Eli-S-Bridge/ETAG_V10/README.md

# ETAG_V10
ETAG arduino code and assembly files for the ETAG RFID reader version 10.
