Eli-S-Bridge/ETAG_V10/ETAG_v10.1_BOM.xls

 |  | ETAG_V10.1 BOM
Quantity | Designator | Description | Value | Footprint | Manufacturer | Part Number | Vendor | price each | purchase volume | notes
1 | Y4 | Crystal oscillator | 32.768Khz | SMD 3.2 mm x 1.5 mm | ABRACON | ABS07-32.768KHZ-T | Vericle | 0.286 | 213 | special price
1 | BAT | Battery cell clip for CR1620 | 16mm | 16MM_Coin_Cell | Keystone electronics | SMTM1632 (https://www.mouser.com/ProductDetail/Renata/SMTM1632?qs=aopNjFtpd%2FvxeJ7rSsRdhg%3D%3D) | Mouser | 0.257 | 100
1 | L1 | Power inductor | 2.2uH | SMT_4X4MM | Bourns | SRN4018TA-2R2M
1 | CREF | Tantalum Capacitor | 4.7uF | SMT 1206 | AVX | TAJA475M016RNJ
1 | F1 | Resettable Fuse PPTC | 6V/0.5A | SMT 1206 | Littlefuse | 1206L050/15YR | Mouser | 0.29 | 100
1 | FLASH | 4-Mbit SPI flash memory | AT45DB041BWIDE | SOIC-8 | Adesto Technologies | AT45DB321E-SHF-B | mouser | 2.63 | 100 | special price (tube) | WinSource | 0.91 | 160 | special price (tube)
1 | D1 | high-speed Switching Diodes | CD1206-S01575 | SMT 1206 | Bourns | CD1206-S01575
1 | Q1 | Power transistor | FDN360P | SSOT-3 | Vishay | SI2323DDS-T1-GE3
1 | VREG | 3.3V voltage regulator | LM3671 | SOT23-5 | ON Semiconductor | LM3671MFX-3.3/NOPB | Winsource | 0.65 | 155
1 | RTC | Real time clock | RV-3029-C3-I2C | SMT 3.7 mm x 2.5 mm | Microcrystal | RV-3129-C3 32.768kHz OPTION B TB QA | Mouser | 2.81 | 100
1 | AT_SAM | Atmel SAML21J Microcontroller | SAMD21J18A | TQFP64_10MM_0.5PITCH | Microchip/Atmel | ATSAMD21J18A-AU | Microchip | 3.5 | 160 tray
1 | SD | SD MMC Card holder | SDMMC06132 | SMT | TE Connectivity | 2041021-4 |  | 1
1 | RESET | Pushbutton 6x6 Smd | TS42031-160R-TR-7260 | SMT-TS42 | TE Connectivity | FSM1LPATR | AliExpress | 0.1 | 200
1 | USB | SMD Mini USB socket | USB-MINIB-5PIN | USB-MINIB | CUI inc | UJ2-MBH-1-SMT-TR | AliExpress | 0.13 | 100
1 | LED1 | SMD Chip LED | Yellow (various) | CHIPLED_0805 | Kingbright (various) | APT2012YC (various) | AliExpress
2 | RAA, RAB | Resistor Chip SMD | 22R | SMT 0805 | various | various
2 | CR1A, CR1B | SMD capacitor | 1.2nF, 250V | SMT 0603 | various | various
2 | CV2A, CV2B | SMD capacitor | 1.5nF, 250V | SMT 0603 | various | various
2 | C9, C10 | SMD capacitor | 22pF | SMT 0603 | various | various
2 | CV1A, CV1B | SMD capacitor | 22pF, 250V | SMT 0603 | various | various
2 | RFA, RFB | RFID front end IC | EM4095 | SO16 | EM Microelectronic | EM4095
2 | L6, L7 | Ferrite Bead for GHz Noise | 30 Ohms | SMT 0805 | Bournes | MH2029-300Y | mouser | 0.027 | 1000
3 | R1,R2,R3 | Resistor Chip SMD | 330R | SMT 0603 | various | various
3 | C55, CGA, CGB | SMD capacitor | 1uF | SMT 0603 | various | various
5 | C3.3V, C4, C5V, C12, C13 | SMD capacitor | 10uF | SMT 0805 | various | various
4 | R4, RC, RD, RINT | Resistor Chip SMD | 10k | SMT 0603 | various | various
6 | C7, CD1A, CD1B, CFA, CFB, CRST | SMD capacitor | 10nF | SMT 0603 | various | various
10 | C3, C08, C21, C56, CBLKA, CBLKB, CD2A, CD2B, CR2A, CR2B | SMD capacitor | 100nF | SMT 0603 | various | various
1 | Switch |  |  |  |  | GF-126-0331 | digiKey/mouser | 0.9
3 | CE1, CE2, CE3 | Electolytic capacitor | 150uF | SMT |  |  | AliExpress
1 | Antenna Header |  |  |  |  |  | AliExpress | 0.5
 |  |  |  |  |  |  |  | 13.08
not assembled: SDPU, SDPD, CE1, CE2, CE3, C53, all pin headers, SWITCH
