Eli-S-Bridge/ETAG_V10/(threads)

Thread 1 (2021-05-07):

How to program for arduino ide

jhindes521, 2021-05-07:
Hi Elis

trying to follow your build but haven’t got the foggiest at how to program it from the arduino ide any guidance would be hugely appreciated.
When choosing the rfid etag board I can never find it on the com port or with an uni flashed as an isp.
Think I’ve made an older version of your board
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
