Eli-S-Bridge/ETAG_V10/ETAG_v10.3_NOSDTRANS.brd

## EAGLE design ETAG_v10.3_NOSDTRANS.brd (2024-06-11)

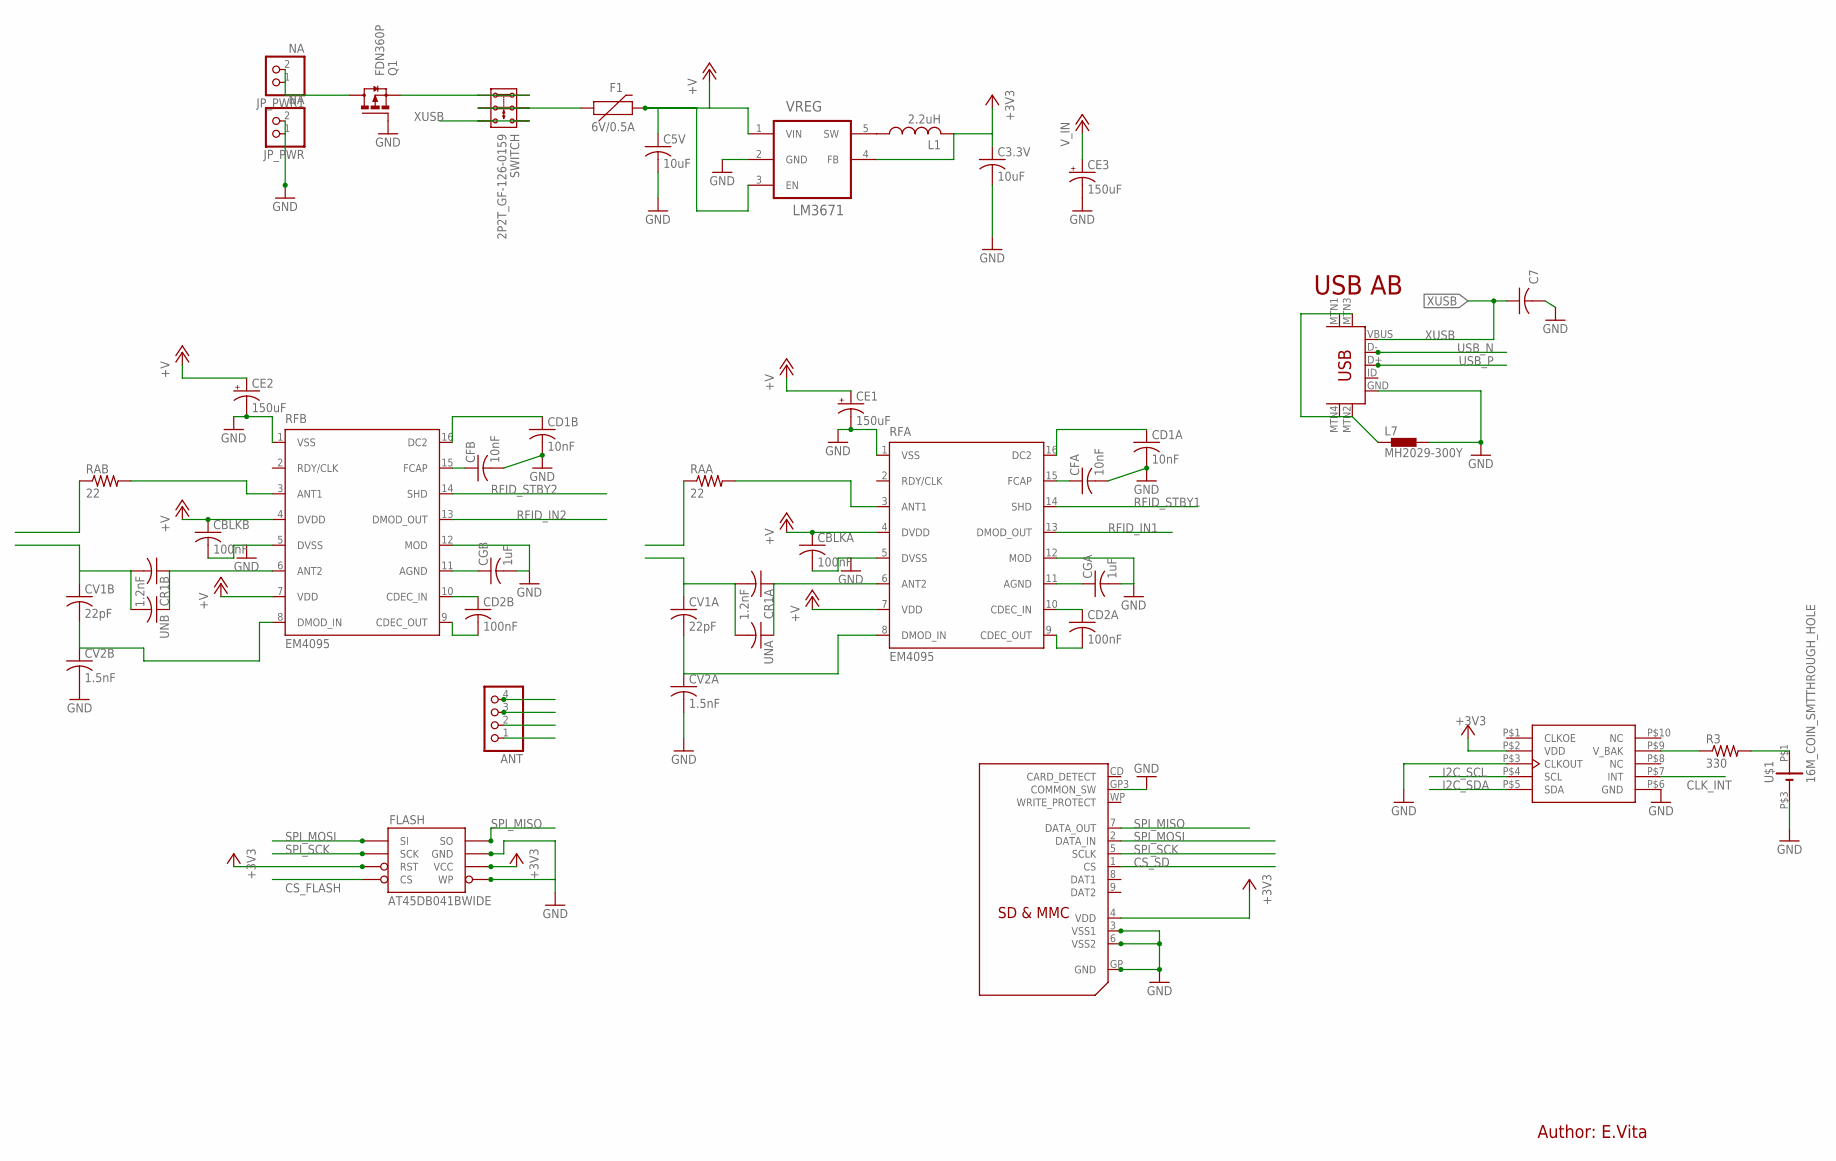
[picture p7: schematic ETAG_v10.3_NOSDTRANS.sch, sheet 1]

Parts:
ANT: PINHD-1X4; 1X04
C3.3V, C5V: 10uF; C0805
C7: 10nF; C0603-ROUND
CBLKA: 100nF; C0603-ROUND
CBLKB: 100nF; C0603-ROUND
CD1A, CD1B: 10nF; C0603-ROUND
CD2A, CD2B: 100nF; C0603-ROUND
CE1, CE2, CE3: 150uF; PANASONIC_C
CFA: 10nF; C0603-ROUND
CFB: 10nF; C0603-ROUND
CGA: 1uF; C0603-ROUND
CGB: 1uF; C0603-ROUND
CR1A, CR1B: 1.2nF; C0603-ROUND
CV1A, CV1B: 22pF; C0603-ROUND
CV2A, CV2B: 1.5nF; C0603-ROUND
F1: 6V/0.5A; 1206
FLASH: AT45DB041BWIDE; SO08WIDE
JP_PWR, JP_PWR1: NA; 1X02
L1: 2.2uH; SMT_COIL_INDUCTOR_4X4MM
L7: MH2029-300Y; C0805K
Q1: FDN360P; SUPER-SOT3
R3: 330; C0603-ROUND
RAA: 22; R0805
RAB: 22; R0805
RFA: EM4095; SO16
RFB: EM4095; SO16
RTC: MC-RTC-RV-3029-C3-I2C; MC-RTC-C3_SPECIAL
SD: SDMMC06132; 06132
SWITCH: 2P2T_GF-126-0159
U$1: 16M_COIN_SMTTHROUGH_HOLE; 16_MM_THROUGH_HOLE
UNA: C-US; C0603-ROUND
UNB: C-US; C0603-ROUND
USB: USB-MINIB-5PIN; USB-MINIB
VREG: LM3671; SOT23-5L

Connections:
2GND: L7.1, USB.MTN1 (MTN2), USB.MTN2 (MTN3), USB.MTN3 (MTN1), USB.MTN4
12_IN: JP_PWR1.1, JP_PWR1.2, Q1.3 (D)
+3V3: C3.3V.1, FLASH.3 (RST), FLASH.6 (VCC), L1.P$2 (2), RTC.P$2 (VDD), SD.4 (VDD), VREG.4 (FB); also elsewhere on the board
AANT: ANT.4, RAA.1
BANT: ANT.2, RAB.1
CLK_INT: RTC.P$7 (INT); also elsewhere on the board
CS_FLASH: FLASH.4 (CS); also elsewhere on the board
CS_SD: SD.1 (CS); also elsewhere on the board
CVA: ANT.3, CR1A.2, CV1A.1, UNA.2
CVB: ANT.1, CR1B.2, CV1B.1, UNB.2
GND: C3.3V.2, C5V.2, C7.2, CBLKA.2, CBLKB.2, CD1A.2, CD1B.2, CE1.-, CE2.-, CE3.-, CFA.2, CFB.2, CGA.2, CGB.2, CV2A.2, CV2B.2, FLASH.5 (WP), FLASH.7 (GND), JP_PWR.1, JP_PWR.2, L7.2, Q1.1 (G), RFA.1 (VSS), RFA.5 (DVSS), RFA.12 (MOD), RFB.1 (VSS), RFB.5 (DVSS), RFB.12 (MOD), RTC.P$3 (CLKOUT), RTC.P$6 (GND), SD.3 (VSS1), SD.6 (VSS2), SD.GP (GND), SD.GP3 (COMMON_SW), U$1.P$3 (-), USB.GND, VREG.2 (GND); also elsewhere on the board
I2C_SCL: RTC.P$4 (SCL); also elsewhere on the board
I2C_SDA: RTC.P$5 (SDA); also elsewhere on the board
unnamed: CFB.1, RFB.15 (FCAP)
unnamed: CGB.1, RFB.11 (AGND)
unnamed: CFA.1, RFA.15 (FCAP)
unnamed: CGA.1, RFA.11 (AGND)
unnamed: CD1A.1, RFA.16 (DC2)
unnamed: CR1B.1, RFB.6 (ANT2), UNB.1
unnamed: CV1B.2, CV2B.1, RFB.8 (DMOD_IN)
unnamed: CD1B.1, RFB.16 (DC2)
unnamed: F1.1, SWITCH.P2A (2.1), SWITCH.P2B (2.2)
unnamed: CD2B.2, RFB.9 (CDEC_OUT)
unnamed: CR1A.1, RFA.6 (ANT2), UNA.1
unnamed: CV1A.2, CV2A.1, RFA.8 (DMOD_IN)
unnamed: CD2B.1, RFB.10 (CDEC_IN)
unnamed: RAB.2, RFB.3 (ANT1)
unnamed: Q1.2 (S), SWITCH.P1A (1.1), SWITCH.P1B (1.2)
unnamed: CD2A.2, RFA.9 (CDEC_OUT)
unnamed: CD2A.1, RFA.10 (CDEC_IN)
unnamed: RAA.2, RFA.3 (ANT1)
unnamed: R3.1, RTC.P$9 (V_BAK)
unnamed: R3.2, U$1.P$1 (+)
RFID_IN1: RFA.13 (DMOD_OUT); also elsewhere on the board
RFID_IN2: RFB.13 (DMOD_OUT); also elsewhere on the board
RFID_STBY1: RFA.14 (SHD); also elsewhere on the board
RFID_STBY2: RFB.14 (SHD); also elsewhere on the board
SPI_MISO: FLASH.8 (SO), SD.7 (DATA_OUT); also elsewhere on the board
SPI_MOSI: FLASH.1 (SI), SD.2 (DATA_IN); also elsewhere on the board
SPI_SCK: FLASH.2 (SCK), SD.5 (SCLK); also elsewhere on the board
SW: L1.P$1 (1), VREG.5 (SW)
USB_N: USB.D-; also elsewhere on the board
USB_P: USB.D+; also elsewhere on the board
V_IN: C5V.1, CBLKA.1, CBLKB.1, CE1.+, CE2.+, CE3.+, F1.2, RFA.4 (DVDD), RFA.7 (VDD), RFB.4 (DVDD), RFB.7 (VDD), VREG.1 (VIN), VREG.3 (EN); also elsewhere on the board
XUSB: C7.1, SWITCH.P3A (3.1), SWITCH.P3B (3.2), USB.VBUS

Notes on the sheet:
USB AB
Author: E.Vita

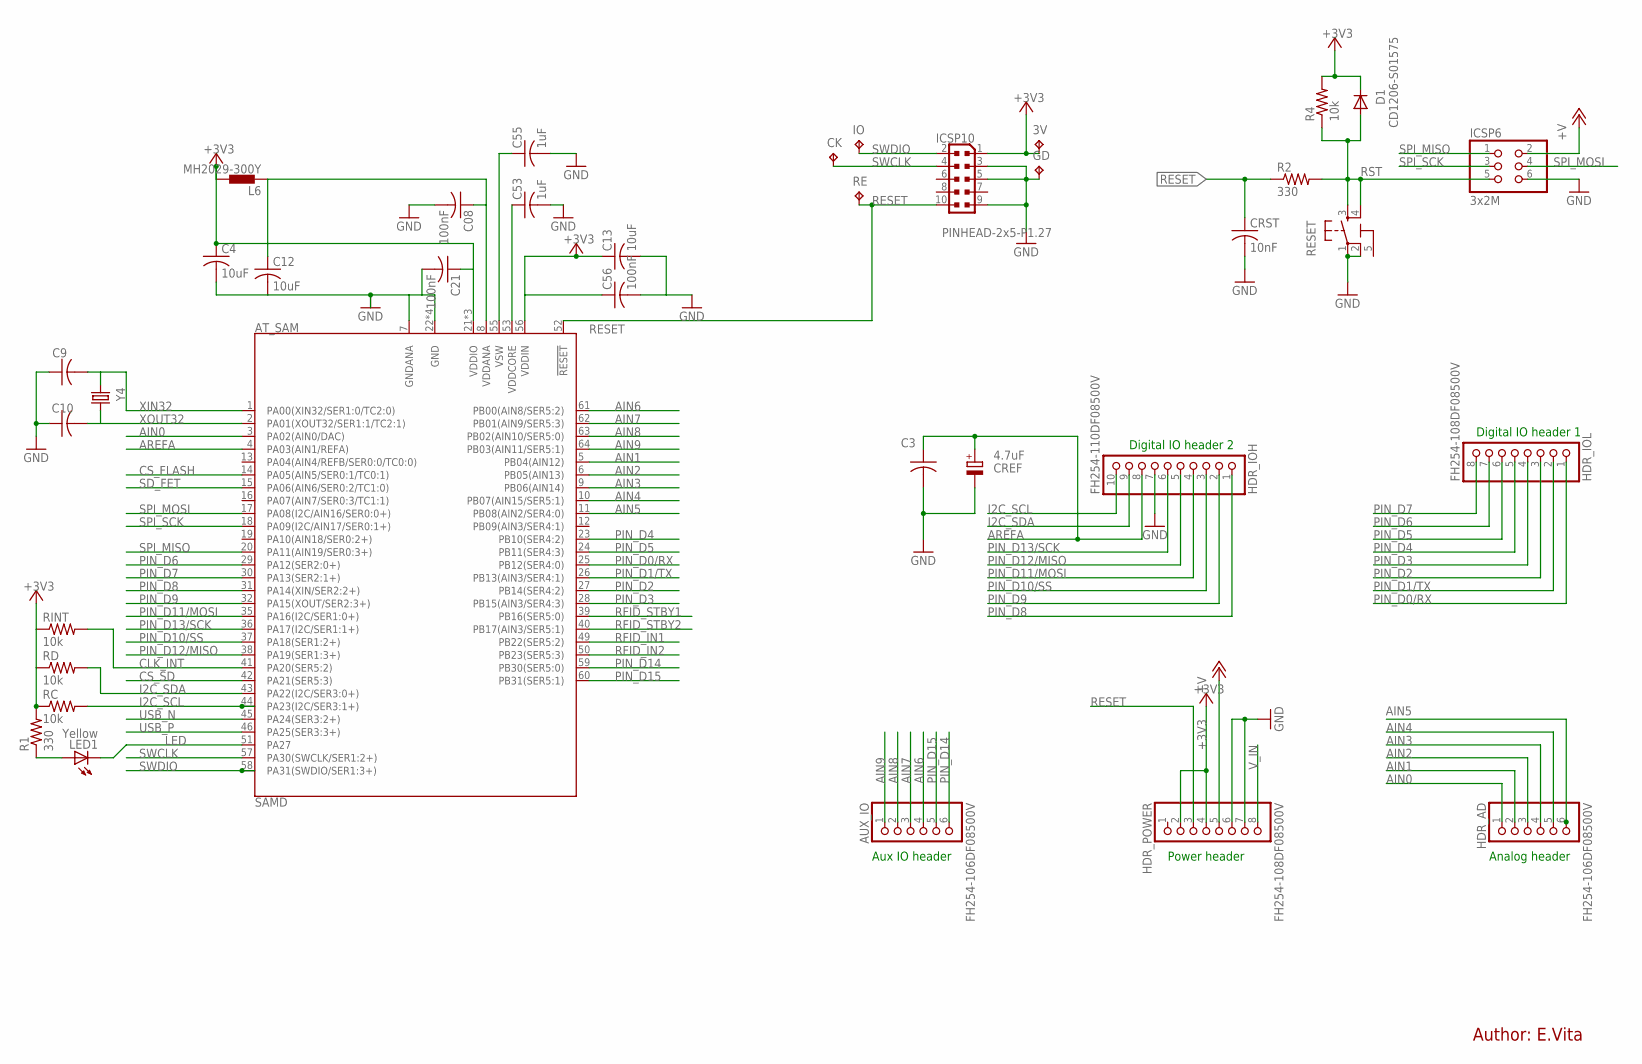
[picture p8: schematic ETAG_v10.3_NOSDTRANS.sch, sheet 2]

Parts:
3V: TPTP12R; TP12R
AT_SAM: SAMD; TQFP_10MM_0.5PITCH
AUX_IO: FH254-106DF08500V; 1X06
C3, C08, C21, C56: 100nF; C0603-ROUND
C4, C12, C13: 10uF; C0805
C9, C10: 22pF; C0603-ROUND
C53, C55: 1uF; C0603-ROUND
CK: TPTP12R; TP12R
CREF: 4.7uF; SMC_A
CRST: 10nF; C0603-ROUND
D1: CD1206-S01575; MINIMELF
GD: TPTP12R; TP12R
HDR_AD: FH254-106DF08500V; 1X06
HDR_IOH: FH254-110DF08500V; 1X10
HDR_IOL: FH254-108DF08500V; 1X08
HDR_POWER: FH254-108DF08500V; 1X08
ICSP6: 3x2M; 2X03
ICSP10: PINHEAD-2x5-P1.27; PINHEAD_2X05_127
IO: TPTP12R; TP12R
L6: MH2029-300Y; C0805K
LED1: Yellow; CHIPLED_0805
R1, R2: 330; C0603-ROUND
R4: 10k; C0603-ROUND
RC: 10k; C0603-ROUND
RD: 10k; C0603-ROUND
RE: TPTP12R; TP12R
RESET: TS42031-160R-TR-7260; TS42
RINT: 10k; C0603-ROUND
Y4: 32,768Khz; RESONATOR_EPSON_FC_145

Connections:
5-GND: RESET.5 (5-GND)
+3V3: 3V.TP, AT_SAM.21 (VDDIO), AT_SAM.34 (VDDIO), AT_SAM.48 (VDDIO), AT_SAM.56 (VDDIN), C4.1, C13.1, C21.1, C56.1, D1.C, HDR_POWER.2, HDR_POWER.4, ICSP10.1, L6.2, R1.2, R4.2, RC.1, RD.1, RINT.1; also elsewhere on the board
AIN0: AT_SAM.3 (PA02(AIN0/DAC)), HDR_AD.1
AIN1: AT_SAM.5 (PB04(AIN12)), HDR_AD.2
AIN2: AT_SAM.6 (PB05(AIN13)), HDR_AD.3
AIN3: AT_SAM.9 (PB06(AIN14)), HDR_AD.4
AIN4: AT_SAM.10 (PB07(AIN15/SER5:1)), HDR_AD.5
AIN5: AT_SAM.11 (PB08(AIN2/SER4:0)), HDR_AD.6
AIN6: AT_SAM.61 (PB00(AIN8/SER5:2)), AUX_IO.4
AIN7: AT_SAM.62 (PB01(AIN9/SER5:3)), AUX_IO.3
AIN8: AT_SAM.63 (PB02(AIN10/SER5:0)), AUX_IO.2
AIN9: AT_SAM.64 (PB03(AIN11/SER5:1)), AUX_IO.1
AREFA: AT_SAM.4 (PA03(AIN1/REFA)), C3.1, CREF.+, HDR_IOH.8
CLK_INT: AT_SAM.41 (PA20(SER5:2)), RINT.2; also elsewhere on the board
CS_FLASH: AT_SAM.14 (PA05(AIN5/SER0:1/TC0:1)); also elsewhere on the board
CS_SD: AT_SAM.42 (PA21(SER5:3)); also elsewhere on the board
GND: AT_SAM.7 (GNDANA), AT_SAM.22 (GND), AT_SAM.33 (GND), AT_SAM.47 (GND), AT_SAM.54 (GND), C3.2, C4.2, C08.2, C9.1, C10.1, C12.2, C13.2, C21.2, C53.2, C55.2, C56.2, CREF.-, CRST.2, GD.TP, HDR_IOH.7, HDR_POWER.6, HDR_POWER.7, ICSP6.6, ICSP10.3, ICSP10.5, ICSP10.9, RESET.1, RESET.2; also elsewhere on the board
I2C_SCL: AT_SAM.44 (PA23(I2C/SER3:1+)), HDR_IOH.10, RC.2; also elsewhere on the board
I2C_SDA: AT_SAM.43 (PA22(I2C/SER3:0+)), HDR_IOH.9, RD.2; also elsewhere on the board
LED: AT_SAM.51 (PA27), LED1.C
unnamed: LED1.A, R1.1
unnamed: AT_SAM.53 (VDDCORE), C53.1
unnamed: AT_SAM.55 (VSW), C55.1
PIN_D0/RX: AT_SAM.25 (PB12(SER4:0)), HDR_IOL.1
PIN_D1/TX: AT_SAM.26 (PB13(AIN3/SER4:1)), HDR_IOL.2
PIN_D2: AT_SAM.27 (PB14(SER4:2)), HDR_IOL.3
PIN_D3: AT_SAM.28 (PB15(AIN3/SER4:3)), HDR_IOL.4
PIN_D4: AT_SAM.23 (PB10(SER4:2)), HDR_IOL.5
PIN_D5: AT_SAM.24 (PB11(SER4:3)), HDR_IOL.6
PIN_D6: AT_SAM.29 (PA12(SER2:0+)), HDR_IOL.7
PIN_D7: AT_SAM.30 (PA13(SER2:1+)), HDR_IOL.8
PIN_D8: AT_SAM.31 (PA14(XIN/SER2:2+)), HDR_IOH.1
PIN_D9: AT_SAM.32 (PA15(XOUT/SER2:3+)), HDR_IOH.2
PIN_D10/SS: AT_SAM.37 (PA18(SER1:2+)), HDR_IOH.3
PIN_D11/MOSI: AT_SAM.35 (PA16(I2C/SER1:0+)), HDR_IOH.4
PIN_D12/MISO: AT_SAM.38 (PA19(SER1:3+)), HDR_IOH.5
PIN_D13/SCK: AT_SAM.36 (PA17(I2C/SER1:1+)), HDR_IOH.6
PIN_D14: AT_SAM.59 (PB30(SER5:0)), AUX_IO.6
PIN_D15: AT_SAM.60 (PB31(SER5:1)), AUX_IO.5
RESET: AT_SAM.52 (!RESET!), CRST.1, HDR_POWER.3, ICSP10.10, R2.1, RE.TP
RFID_IN1: AT_SAM.49 (PB22(SER5:2)); also elsewhere on the board
RFID_IN2: AT_SAM.50 (PB23(SER5:3)); also elsewhere on the board
RFID_STBY1: AT_SAM.39 (PB16(SER5:0)); also elsewhere on the board
RFID_STBY2: AT_SAM.40 (PB17(AIN3/SER5:1)); also elsewhere on the board
RST: D1.A, ICSP6.5, R2.2, R4.1, RESET.3, RESET.4
SD_FET: AT_SAM.15 (PA06(AIN6/SER0:2/TC1:0))
SPI_MISO: AT_SAM.20 (PA11(AIN19/SER0:3+)), ICSP6.1; also elsewhere on the board
SPI_MOSI: AT_SAM.17 (PA08(I2C/AIN16/SER0:0+)), ICSP6.4; also elsewhere on the board
SPI_SCK: AT_SAM.18 (PA09(I2C/AIN17/SER0:1+)), ICSP6.3; also elsewhere on the board
SWCLK: AT_SAM.57 (PA30(SWCLK/SER1:2+)), CK.TP, ICSP10.4
SWDIO: AT_SAM.58 (PA31(SWDIO/SER1:3+)), ICSP10.2, IO.TP
USB_N: AT_SAM.45 (PA24(SER3:2+)); also elsewhere on the board
USB_P: AT_SAM.46 (PA25(SER3:3+)); also elsewhere on the board
VDDANA: AT_SAM.8 (VDDANA), C08.1, C12.1, L6.1
V_IN: HDR_POWER.5, HDR_POWER.8, ICSP6.2; also elsewhere on the board
XIN32: AT_SAM.1 (PA00(XIN32/SER1:0/TC2:0)), C9.2, Y4.P$1 (1)
XOUT32: AT_SAM.2 (PA01(XOUT32/SER1:1/TC2:1)), C10.2, Y4.P$2 (2)

Notes on the sheet:
Author: E.Vita
Digital IO header 2
Digital IO header 1
Analog header
Power header
Aux IO header

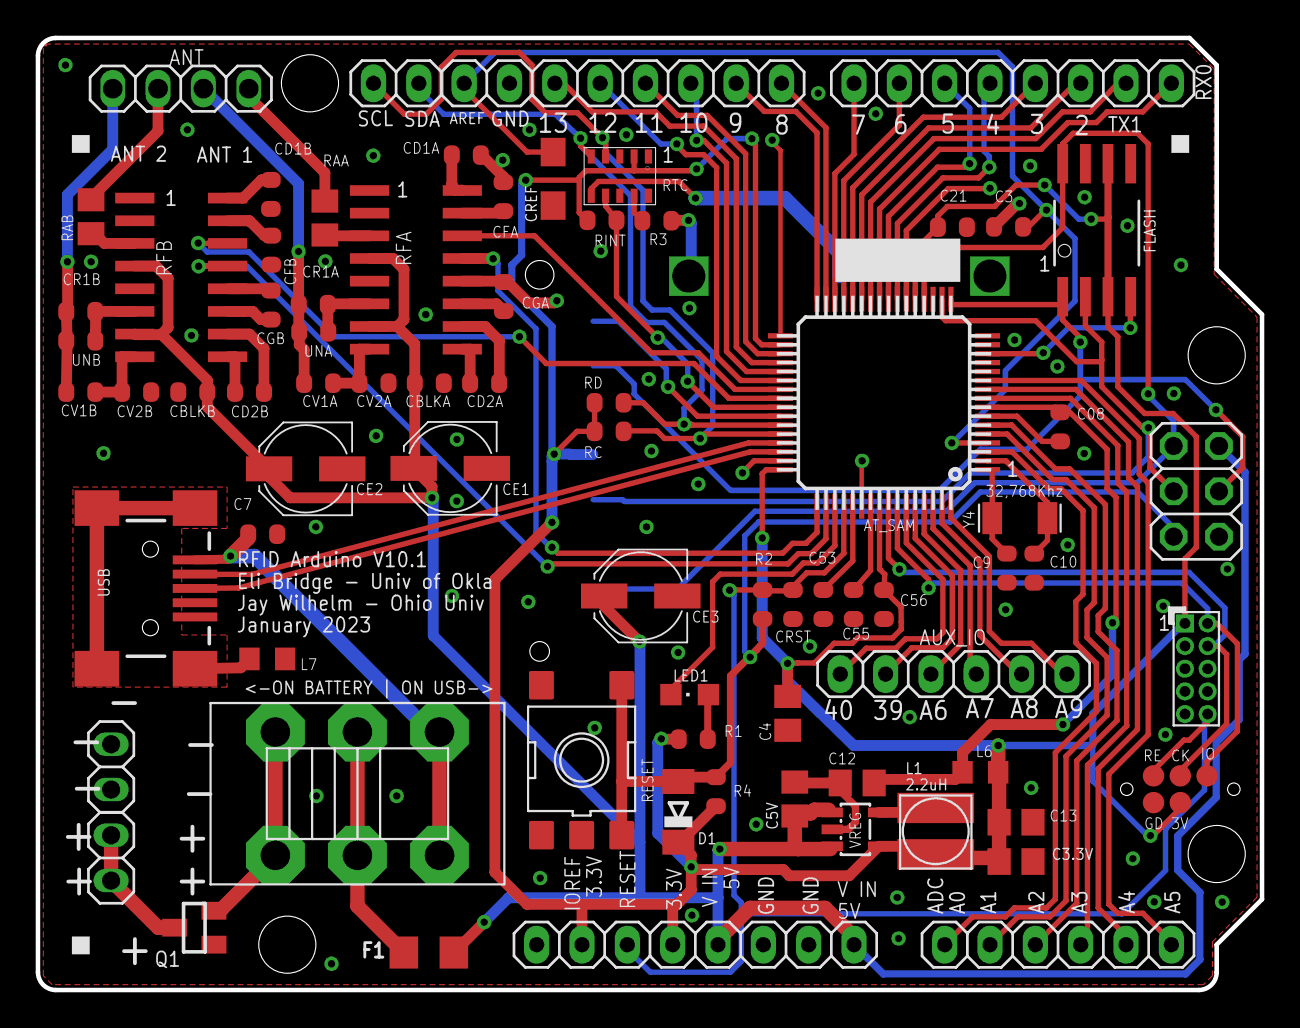
[picture p9: board ETAG_v10.3_NOSDTRANS.brd from above]

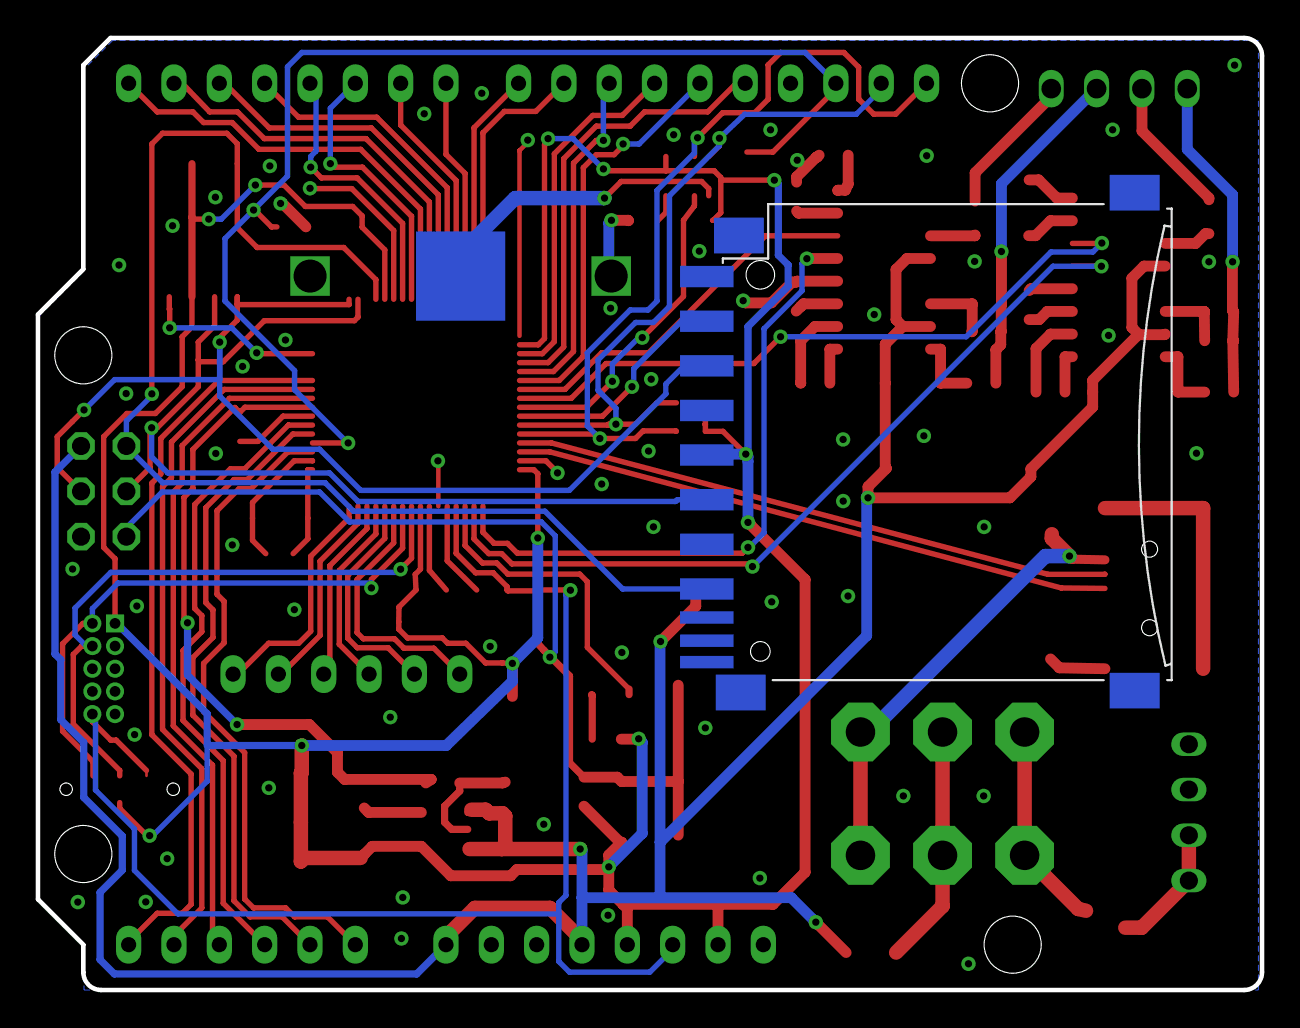
[picture p10: board ETAG_v10.3_NOSDTRANS.brd from below]

Board: 4 copper layers, 68.6 x 53.3 mm, 83 parts (2 on the bottom side), 83 nets.

Other parts of the board:
U$2, U$3, U$4: SQUARE-1MM-3R
