Eli-S-Bridge/ETAG_V10/(commit log)

2019-10-23 Initial upload
    Version 10 script. Uses built in SD library (may want to switch to SDfat later)
2019-11-11 Added board assembly files
    Added eagle files and gerbers
    [ETAG_v10.0_EM4095.brd, ETAG_v10.0_EM4095.sch]
2019-11-16 Added assembly files and pics
    Added gerbers and BOM spreadsheet. Also pics of PCB array and finished boards
    [ETAG_v10.0_EM4095_BOM_&_Placement.xlsx]
2020-01-28 date bug fixed
    Day and year were reversed on dates written to SD card. Now fixed
    [ETAG_V10.ino, Manchester.h]
2023-03-16 Added IOS tags
    Mar 2023 - simplified Flash memory writing - one write command and one read command that automatically writes across pages.
    - Added ISO11784/5 tag reading capability and temperature tags!!!! set global ISO variable to 1 for ISO tags.
    - Progressed toward elimination of string variables (still some strings used with the real time clock)
    - revamped SD card storage functions
    - enabled log files for both SD and Flash logging modes
    - Revamped file storage. New file created for each data transfer.
2023-03-25 Update ETAG_V10.ino
    fixed frame error on logged date
    [ETAG_V10.ino]
2023-04-04 Bugfix_Apr4_2023
    Fixed bug that saved dates as 0s to SD card
    [ETAG_V10.ino]
2023-09-12 New data logging scheme
    Updates to SD card now involve matching up data lines to prevent writing duplicated data
    [ETAG_V10.ino]
2024-05-21 updated manual
    Fixed some inaccuracies in the manual.
    [ETAG_v10.1_BOM.xls]
2024-06-11 updated hardware files
    Finally put the new board file up. (v10.3)
    [ETAG_v10.0_EM4095_BOM_&_Placement.xlsx, ETAG_v10.3_NOSDTRANS.brd, ETAG_v10.3_NOSDTRANS.sch]
2026-02-06 Major Update - new menu and sleep modes
    Major Update - new menu setup that allows for parameter setting without reprogramming. updated sleepn to work with ISO mode. Also manual has been updated, but still need Arduino 2 and windows 11 updates.
